Hyiger-Designs/SMC-80_DE10/SMC-80_DE10.kicad_pcb

## KiCad design SMC-80_DE10.kicad_pcb (2020-05-27)

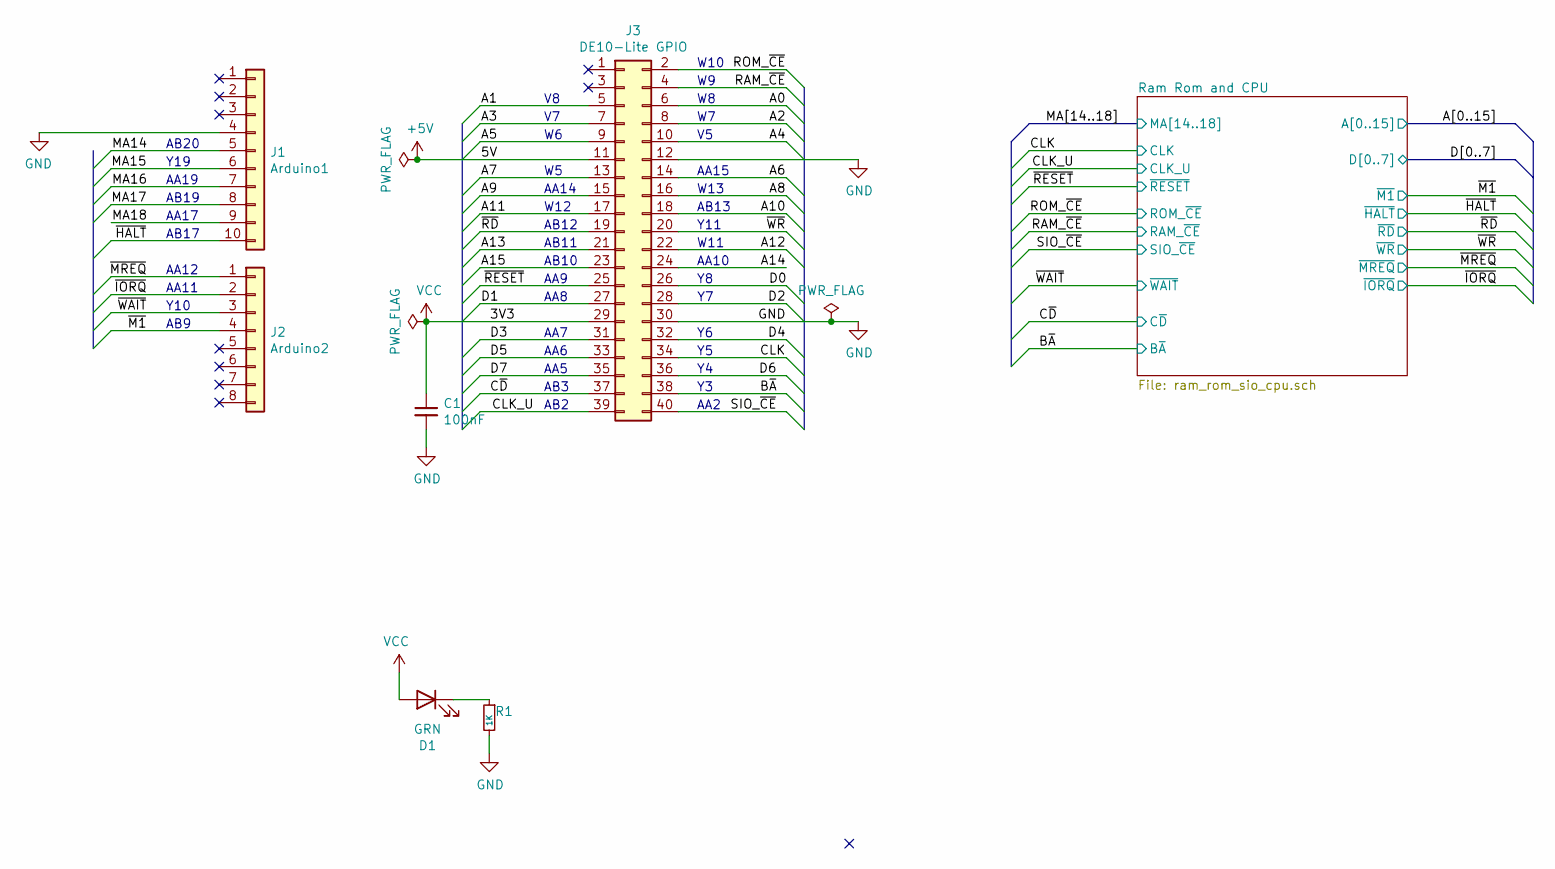
[picture p1: schematic SMC-80_DE10.sch, SMC-80 Lite - Terasic DE10 Z80 Adapter Board]

Parts:
C1: 100nF; C_0603_1608Metric_Pad1.05x0.95mm_HandSolder
D1: GRN; LED_0603_1608Metric_Pad1.05x0.95mm_HandSolder
J1: Arduino1; PinHeader_1x10_P2.54mm_Vertical
J2: Arduino2; PinHeader_1x08_P2.54mm_Vertical
J3: DE10-Lite GPIO; PinSocket_2x20_P2.54mm_Vertical
R1: 1K; R_0603_1608Metric_Pad1.05x0.95mm_HandSolder

Connections:
+5V: J3.11
/A0: J3.6; also elsewhere on the board
/A1: J3.5; also elsewhere on the board
/A2: J3.8; also elsewhere on the board
/A3: J3.7; also elsewhere on the board
/A4: J3.10; also elsewhere on the board
/A5: J3.9; also elsewhere on the board
/A6: J3.14; also elsewhere on the board
/A7: J3.13; also elsewhere on the board
/A8: J3.16; also elsewhere on the board
/A9: J3.15; also elsewhere on the board
/A10: J3.18; also elsewhere on the board
/A11: J3.17; also elsewhere on the board
/A12: J3.22; also elsewhere on the board
/A13: J3.21; also elsewhere on the board
/A14: J3.24; also elsewhere on the board
/A15: J3.23; also elsewhere on the board
/B~A: J3.38; also elsewhere on the board
/CLK: J3.34; also elsewhere on the board
/CLK_U: J3.39; also elsewhere on the board
/C~D: J3.37; also elsewhere on the board
/D0: J3.26; also elsewhere on the board
/D1: J3.27; also elsewhere on the board
/D2: J3.28; also elsewhere on the board
/D3: J3.31; also elsewhere on the board
/D4: J3.32; also elsewhere on the board
/D5: J3.33; also elsewhere on the board
/D6: J3.36; also elsewhere on the board
/D7: J3.35; also elsewhere on the board
/MA14: J1.5; also elsewhere on the board
/MA15: J1.6; also elsewhere on the board
/MA16: J1.7; also elsewhere on the board
/MA17: J1.8; also elsewhere on the board
/MA18: J1.9; also elsewhere on the board
/RAM_~CE: J3.4; also elsewhere on the board
/ROM_~CE: J3.2; also elsewhere on the board
/SIO_~CE: J3.40; also elsewhere on the board
/~HALT: J1.10; also elsewhere on the board
/~IORQ: J2.2; also elsewhere on the board
/~M1: J2.4; also elsewhere on the board
/~MREQ: J2.1; also elsewhere on the board
/~RD: J3.19; also elsewhere on the board
/~RESET: J3.25; also elsewhere on the board
/~WAIT: J2.3; also elsewhere on the board
/~WR: J3.20; also elsewhere on the board
GND: C1.2, J1.4, J3.12, J3.30, R1.2; also elsewhere on the board
unnamed: D1.1 (K), R1.1
VCC: C1.1, D1.2 (A), J3.29; also elsewhere on the board

Notes on the sheet:
AB9
AA19
Y19
AB20
AB2
AB12
AB11
AB10
AA9
AA8
W11
AA10
AA7
AA6
W12
AA2
Y11
AB13
W13
AA15
W10
AA14
AA12
AA11
Y10
AB19
AA17
AB17
AA5
AB3

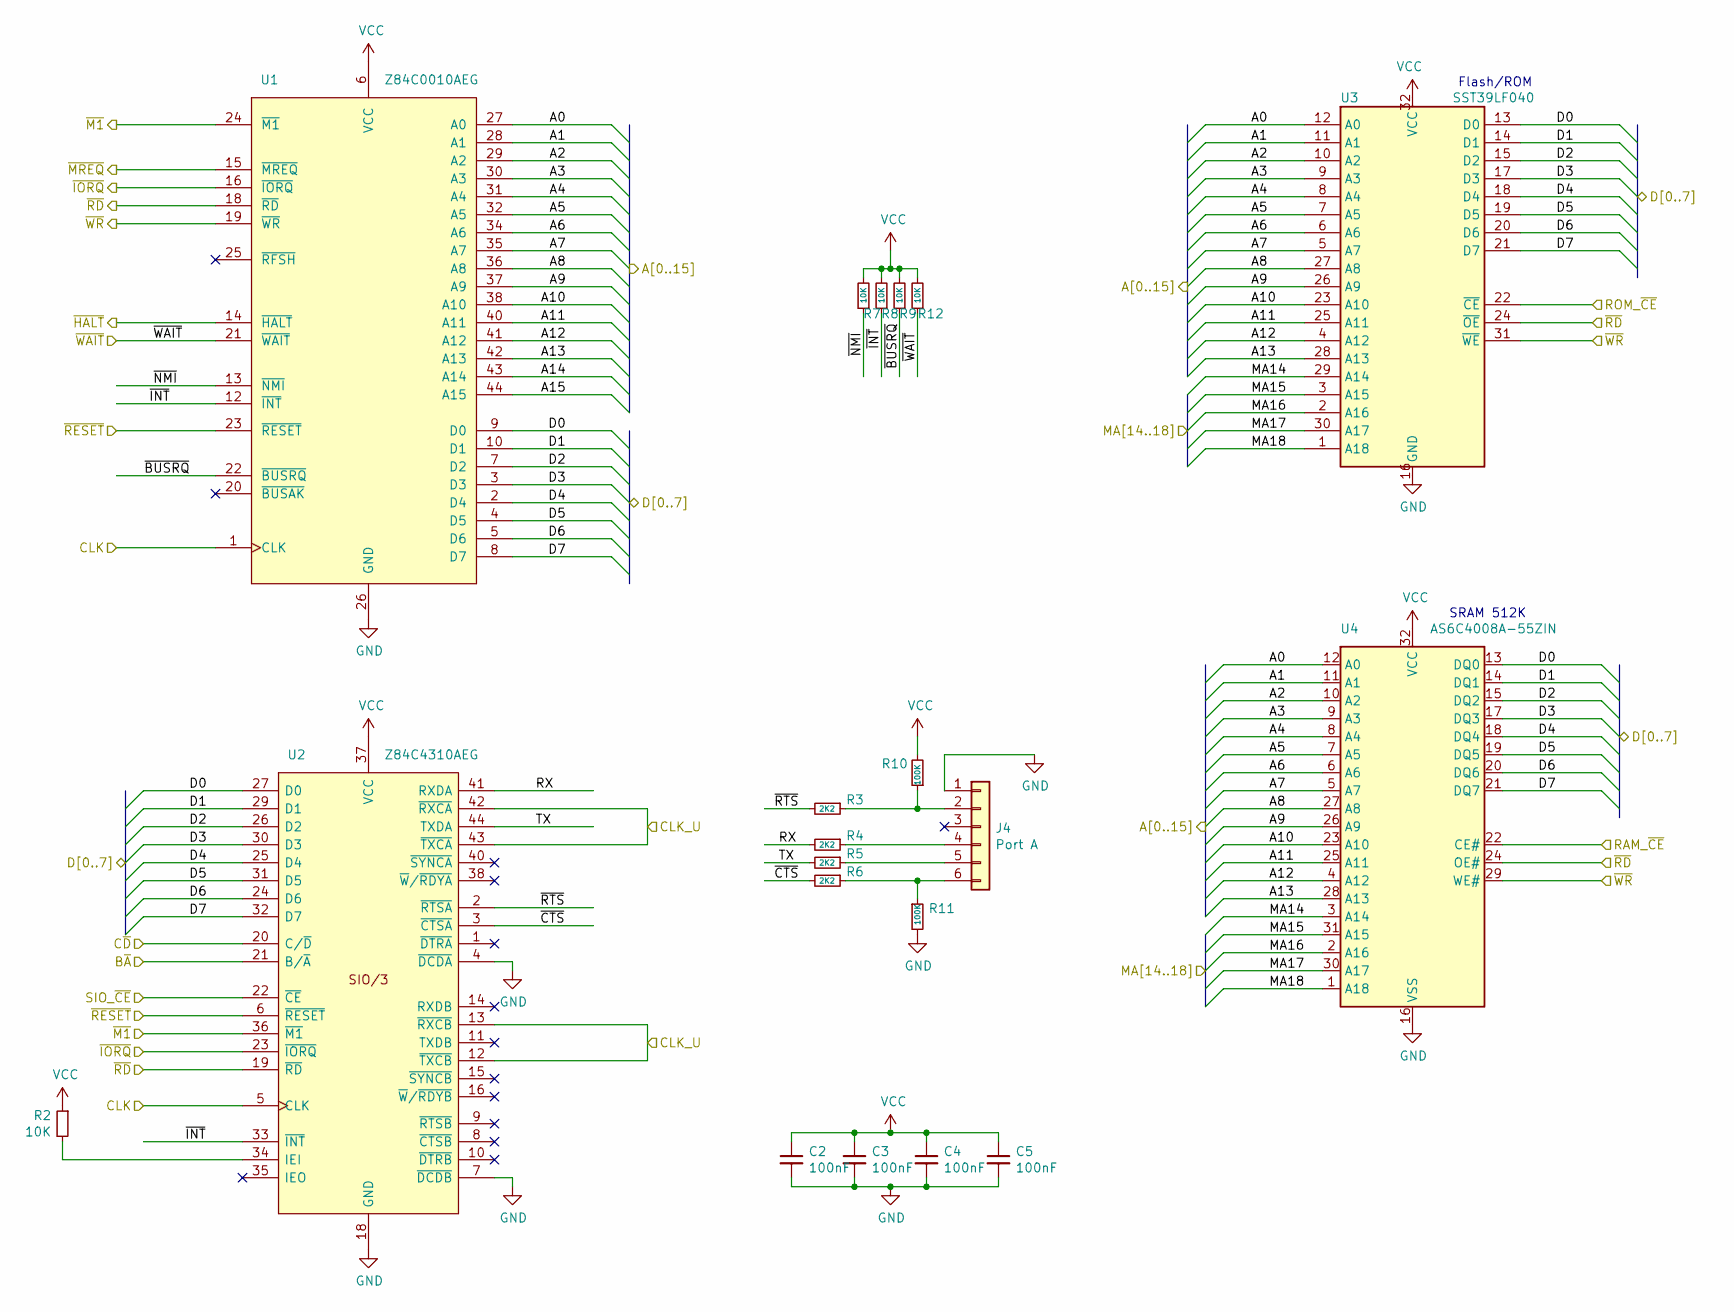
[picture p2: schematic ram_rom_sio_cpu.sch, SMC-80 DE10 Lite Edition]

Parts:
C2, C3, C4, C5: 100nF; C_0603_1608Metric_Pad1.05x0.95mm_HandSolder
J4: Port A; PinHeader_1x06_P2.54mm_Vertical
R2, R7, R8, R9, R12: 10K; R_0603_1608Metric_Pad1.05x0.95mm_HandSolder
R3, R4, R5, R6: 2K2; R_0603_1608Metric_Pad1.05x0.95mm_HandSolder
R10, R11: 100K; R_0603_1608Metric_Pad1.05x0.95mm_HandSolder
U1: Z84C0010AEG; LQFP-44_10x10mm_P0.8mm; Manufacturer_Part_Number Z84C0010AEG
U2: Z84C4310AEG; LQFP-44_10x10mm_P0.8mm; Manufacturer_Part_Number Z84C4310AEG
U3: SST39LF040; PLCC-32_11.4x14.0mm_P1.27mm-Socket; Manufacturer_Part_Number SST39LF040-55-4C-NHE
U4: AS6C4008A-55ZIN; TSOP-II-32_21.0x10.2mm_P1.27mm; Manufacturer_Part_Number AS6C4008A-55ZIN

Connections:
/A0: U1.27 (A0), U3.12 (A0), U4.12 (A0); also elsewhere on the board
/A1: U1.28 (A1), U3.11 (A1), U4.11 (A1); also elsewhere on the board
/A2: U1.29 (A2), U3.10 (A2), U4.10 (A2); also elsewhere on the board
/A3: U1.30 (A3), U3.9 (A3), U4.9 (A3); also elsewhere on the board
/A4: U1.31 (A4), U3.8 (A4), U4.8 (A4); also elsewhere on the board
/A5: U1.32 (A5), U3.7 (A5), U4.7 (A5); also elsewhere on the board
/A6: U1.34 (A6), U3.6 (A6), U4.6 (A6); also elsewhere on the board
/A7: U1.35 (A7), U3.5 (A7), U4.5 (A7); also elsewhere on the board
/A8: U1.36 (A8), U3.27 (A8), U4.27 (A8); also elsewhere on the board
/A9: U1.37 (A9), U3.26 (A9), U4.26 (A9); also elsewhere on the board
/A10: U1.38 (A10), U3.23 (A10), U4.23 (A10); also elsewhere on the board
/A11: U1.40 (A11), U3.25 (A11), U4.25 (A11); also elsewhere on the board
/A12: U1.41 (A12), U3.4 (A12), U4.4 (A12); also elsewhere on the board
/A13: U1.42 (A13), U3.28 (A13), U4.28 (A13); also elsewhere on the board
/A14: U1.43 (A14); also elsewhere on the board
/A15: U1.44 (A15); also elsewhere on the board
/B~A: U2.21 (B/~A); also elsewhere on the board
/CLK: U1.1 (CLK), U2.5 (CLK); also elsewhere on the board
/CLK_U: U2.12 (~TXCB), U2.13 (~RXCB), U2.42 (~RXCA), U2.43 (~TXCA); also elsewhere on the board
/C~D: U2.20 (C/~D); also elsewhere on the board
/D0: U1.9 (D0), U2.27 (D0), U3.13 (D0), U4.13 (DQ0); also elsewhere on the board
/D1: U1.10 (D1), U2.29 (D1), U3.14 (D1), U4.14 (DQ1); also elsewhere on the board
/D2: U1.7 (D2), U2.26 (D2), U3.15 (D2), U4.15 (DQ2); also elsewhere on the board
/D3: U1.3 (D3), U2.30 (D3), U3.17 (D3), U4.17 (DQ3); also elsewhere on the board
/D4: U1.2 (D4), U2.25 (D4), U3.18 (D4), U4.18 (DQ4); also elsewhere on the board
/D5: U1.4 (D5), U2.31 (D5), U3.19 (D5), U4.19 (DQ5); also elsewhere on the board
/D6: U1.5 (D6), U2.24 (D6), U3.20 (D6), U4.20 (DQ6); also elsewhere on the board
/D7: U1.8 (D7), U2.32 (D7), U3.21 (D7), U4.21 (DQ7); also elsewhere on the board
/MA14: U3.29 (A14), U4.3 (A14); also elsewhere on the board
/MA15: U3.3 (A15), U4.31 (A15); also elsewhere on the board
/MA16: U3.2 (A16), U4.2 (A16); also elsewhere on the board
/MA17: U3.30 (A17), U4.30 (A17); also elsewhere on the board
/MA18: U3.1 (A18), U4.1 (A18); also elsewhere on the board
/RAM_~CE: U4.22 (CE#); also elsewhere on the board
/ROM_~CE: U3.22 (~CE); also elsewhere on the board
/Ram Rom and CPU/RX: R4.2, U2.41 (RXDA)
/Ram Rom and CPU/TX: R5.2, U2.44 (TXDA)
/Ram Rom and CPU/~BUSRQ: R9.1, U1.22 (~BUSRQ)
/Ram Rom and CPU/~CTS: R6.2, U2.3 (~CTSA)
/Ram Rom and CPU/~INT: R8.1, U1.12 (~INT), U2.33 (~INT)
/Ram Rom and CPU/~NMI: R7.1, U1.13 (~NMI)
/Ram Rom and CPU/~RTS: R3.2, U2.2 (~RTSA)
/SIO_~CE: U2.22 (~CE); also elsewhere on the board
/~HALT: U1.14 (~HALT); also elsewhere on the board
/~IORQ: U1.16 (~IORQ), U2.23 (~IORQ); also elsewhere on the board
/~M1: U1.24 (~M1), U2.36 (~M1); also elsewhere on the board
/~MREQ: U1.15 (~MREQ); also elsewhere on the board
/~RD: U1.18 (~RD), U2.19 (~RD), U3.24 (~OE), U4.24 (OE#); also elsewhere on the board
/~RESET: U1.23 (~RESET), U2.6 (~RESET); also elsewhere on the board
/~WAIT: R12.1, U1.21 (~WAIT); also elsewhere on the board
/~WR: U1.19 (~WR), U3.31 (~WE), U4.29 (WE#); also elsewhere on the board
GND: C2.2, C3.2, C4.2, C5.2, J4.1, R11.2, U1.26 (GND), U2.4 (~DCDA), U2.7 (~DCDB), U2.18 (GND), U3.16 (GND), U4.16 (VSS); also elsewhere on the board
unnamed: J4.2, R3.1, R10.1
unnamed: J4.4, R4.1
unnamed: J4.5, R5.1
unnamed: J4.6, R6.1, R11.1
unnamed: R2.2, U2.34 (IEI)
VCC: C2.1, C3.1, C4.1, C5.1, R2.1, R7.2, R8.2, R9.2, R10.2, R12.2, U1.6 (VCC), U2.37 (VCC), U3.32 (VCC), U4.32 (VCC); also elsewhere on the board

Notes on the sheet:
Flash/ROM
SRAM 512K

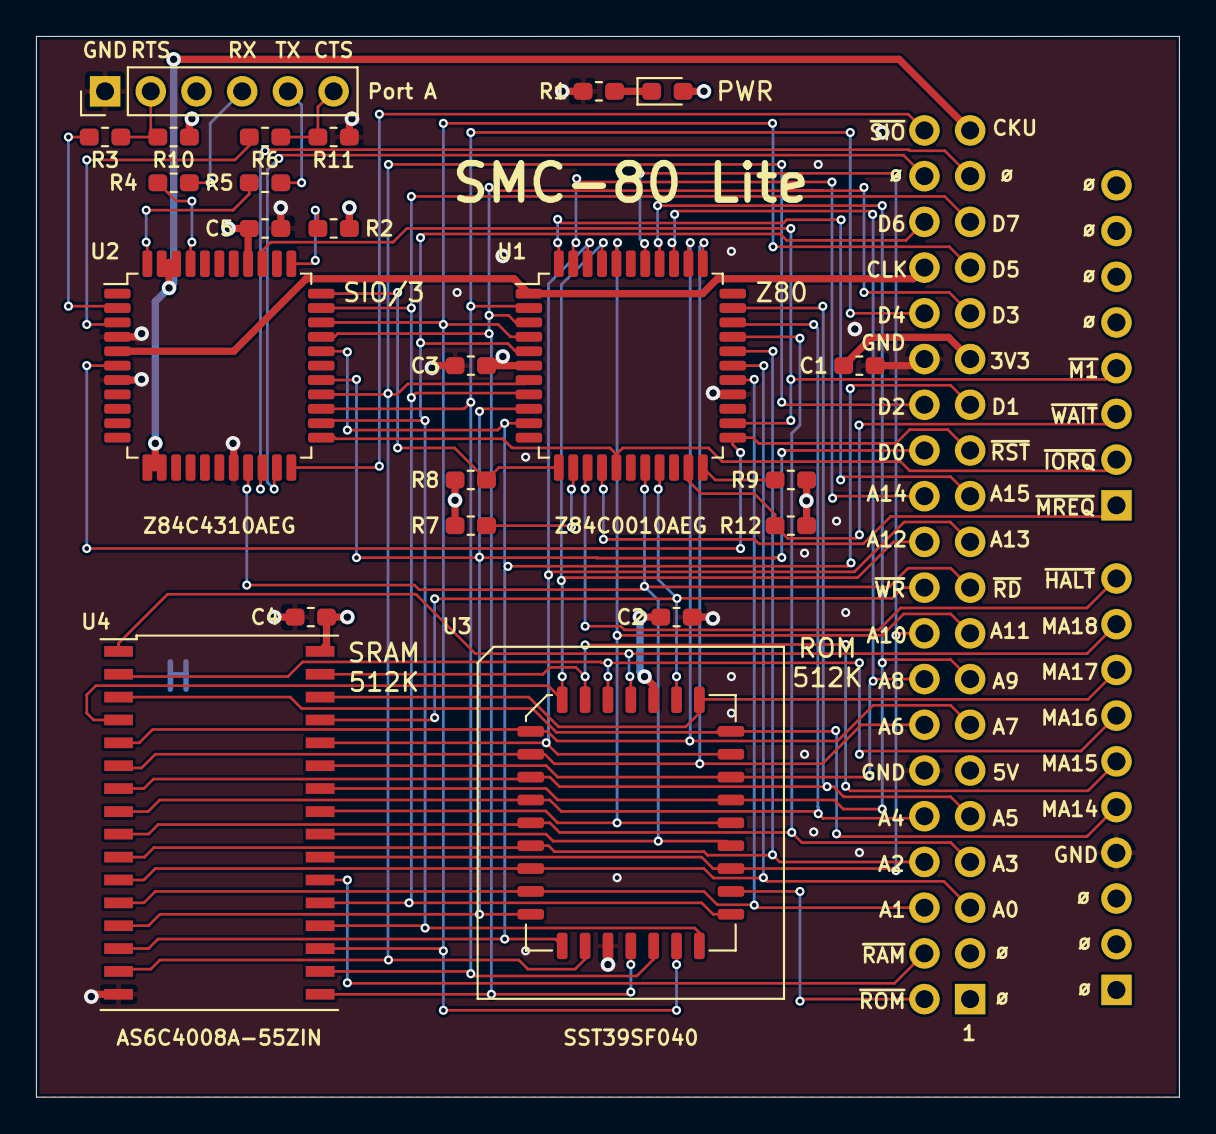
[picture p3: board SMC-80_DE10.kicad_pcb from above]

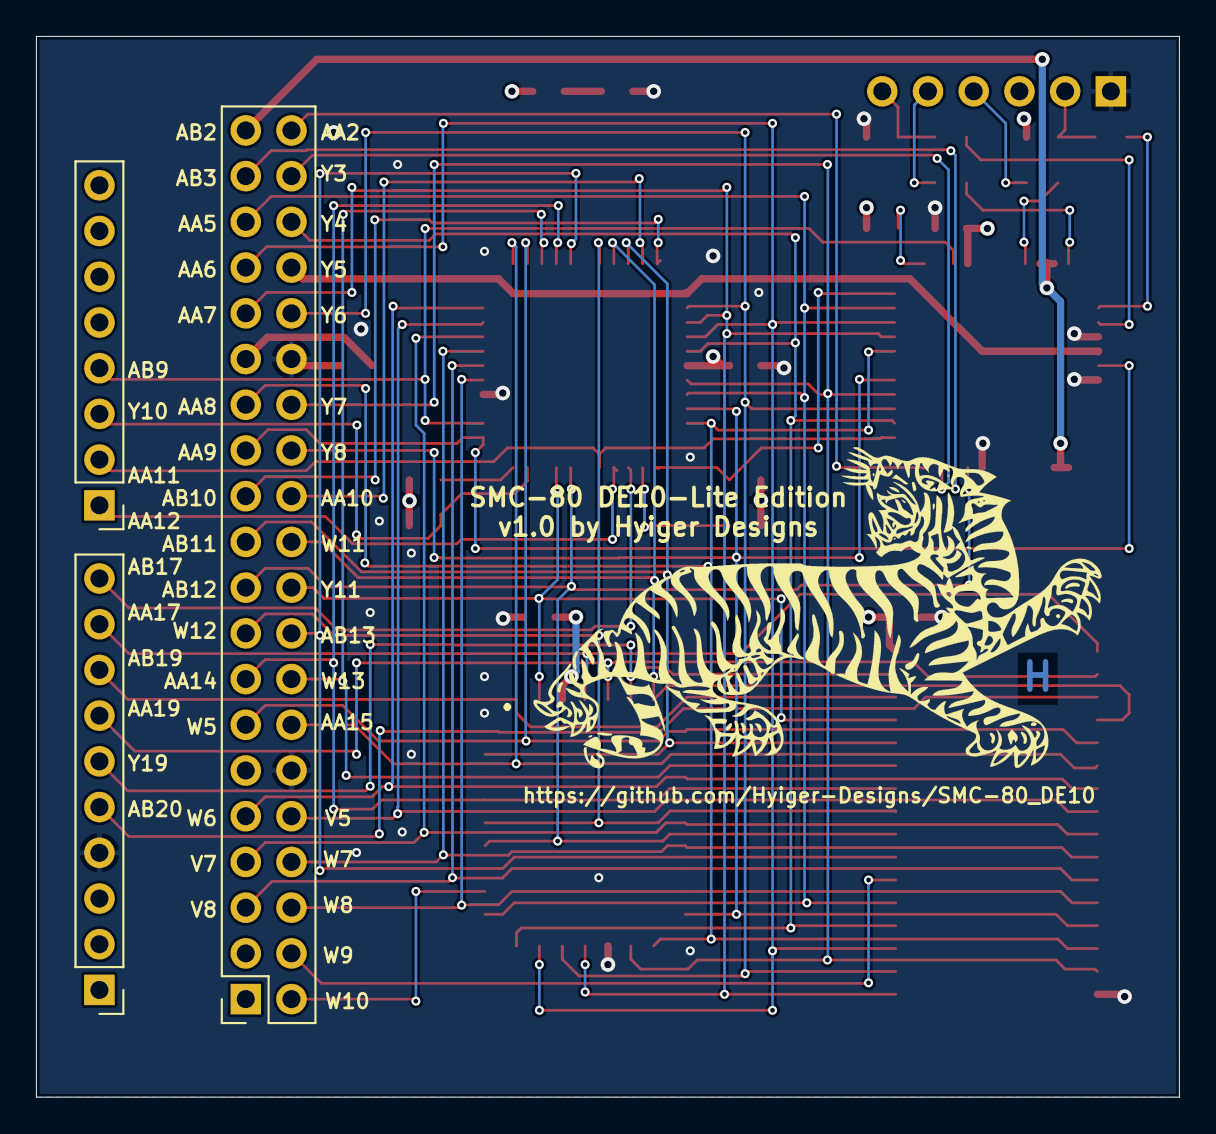
[picture p4: board SMC-80_DE10.kicad_pcb from below]

Board: 4 copper layers, 63.5 x 58.9 mm, 26 parts (3 on the bottom side), 59 nets.
