Hyiger-Designs/SMC-80_DE10/(commit log)

2020-04-22 Initial version
    [SMC-80_DE10.kicad_pcb, SMC-80_DE10.sch, ram_rom_sio_cpu.sch]
2020-04-22 Renamed to SMC-80 DE10, new layout
    [SMC-80_DE10.sch]
2020-04-22 added kicad specific gitignore
2020-04-23 rotated layout
    [SMC-80_DE10.kicad_pcb, SMC-80_DE10.sch, ram_rom_sio_cpu.sch]
2020-04-23 Routing completed, fixed RAM/ROM paging
    [SMC-80_DE10.kicad_pcb, SMC-80_DE10.sch, ram_rom_sio_cpu.sch]
2020-04-24 added gnd plane stitching
    [SMC-80_DE10.kicad_pcb, SMC-80_DE10.sch, ram_rom_sio_cpu.sch]
2020-04-24 enhanced graphic for PLCC socket
    [SMC-80_DE10.kicad_pcb, ram_rom_sio_cpu.sch]
2020-04-25 removed ram/rom ce pullups
    [SMC-80_DE10.kicad_pcb, SMC-80_DE10.sch, ram_rom_sio_cpu.sch]
2020-04-28 added FPGA pin labels
    [SMC-80_DE10.kicad_pcb, SMC-80_DE10.sch, ram_rom_sio_cpu.sch]
2020-04-28 shifted Arduino pins
    [SMC-80_DE10.kicad_pcb, ram_rom_sio_cpu.sch]
2020-04-28 shifted some components
    [SMC-80_DE10.kicad_pcb]
2020-05-01 final version 1.0
    [SMC-80_DE10.kicad_pcb, SMC-80_DE10.sch]
2020-05-01 fixed DRC error
    [SMC-80_DE10.kicad_pcb]
2020-05-01 Fixed up silkscreens
    [SMC-80_DE10.kicad_pcb]
2020-05-02 normalize symbols
    [SMC-80_DE10.kicad_pcb, ram_rom_sio_cpu.sch]
2020-05-02 reorganized SIO
    [SMC-80_DE10.kicad_pcb, SMC-80_DE10.sch, ram_rom_sio_cpu.sch]
2020-05-02 fixed up gnd plane regions
    [SMC-80_DE10.kicad_pcb]
2020-05-03 reorganized schematic, added missing pin label
    [SMC-80_DE10.kicad_pcb, SMC-80_DE10.sch, ram_rom_sio_cpu.sch]
2020-05-04 added SIO port B clock
    [SMC-80_DE10.kicad_pcb, ram_rom_sio_cpu.sch]
2020-05-05 Broke out SIO C/D and B/A pins
    [SMC-80_DE10.kicad_pcb, SMC-80_DE10.sch, ram_rom_sio_cpu.sch]
2020-05-06 Add bottom silkscreens for FPGA pins
    [SMC-80_DE10.kicad_pcb]
2020-05-06 extra space for z80 pullups
    [SMC-80_DE10.kicad_pcb]
2020-05-07 smoothed traces
    [SMC-80_DE10.kicad_pcb]
2020-05-07 added version and titles to schematic and board
    [SMC-80_DE10.kicad_pcb, SMC-80_DE10.sch, ram_rom_sio_cpu.sch]
2020-05-07 cleanup tracks and vias
    [SMC-80_DE10.kicad_pcb]
2020-05-27 gnd plane changes
    [SMC-80_DE10.kicad_pcb, ram_rom_sio_cpu.sch]
2020-06-02 test benches and bug fixes
    [SMC_80_DE10.vhd, SMC_80_DE10_tb.vhd, SRAM.vhd, SRAM_tb.vhd]
